garyStofer/AIR_TFT_12ADC/README.md

# AIR_TFT_12ADC
12x ADC for EGT and CHT on a TFT display using an ATMEGA 328P controller
