garyStofer/AIR_TFT_12ADC/hardware/12adc_Disp_AIR.sch

## EAGLE design hardware/12adc_Disp_AIR.sch (2020-06-30)

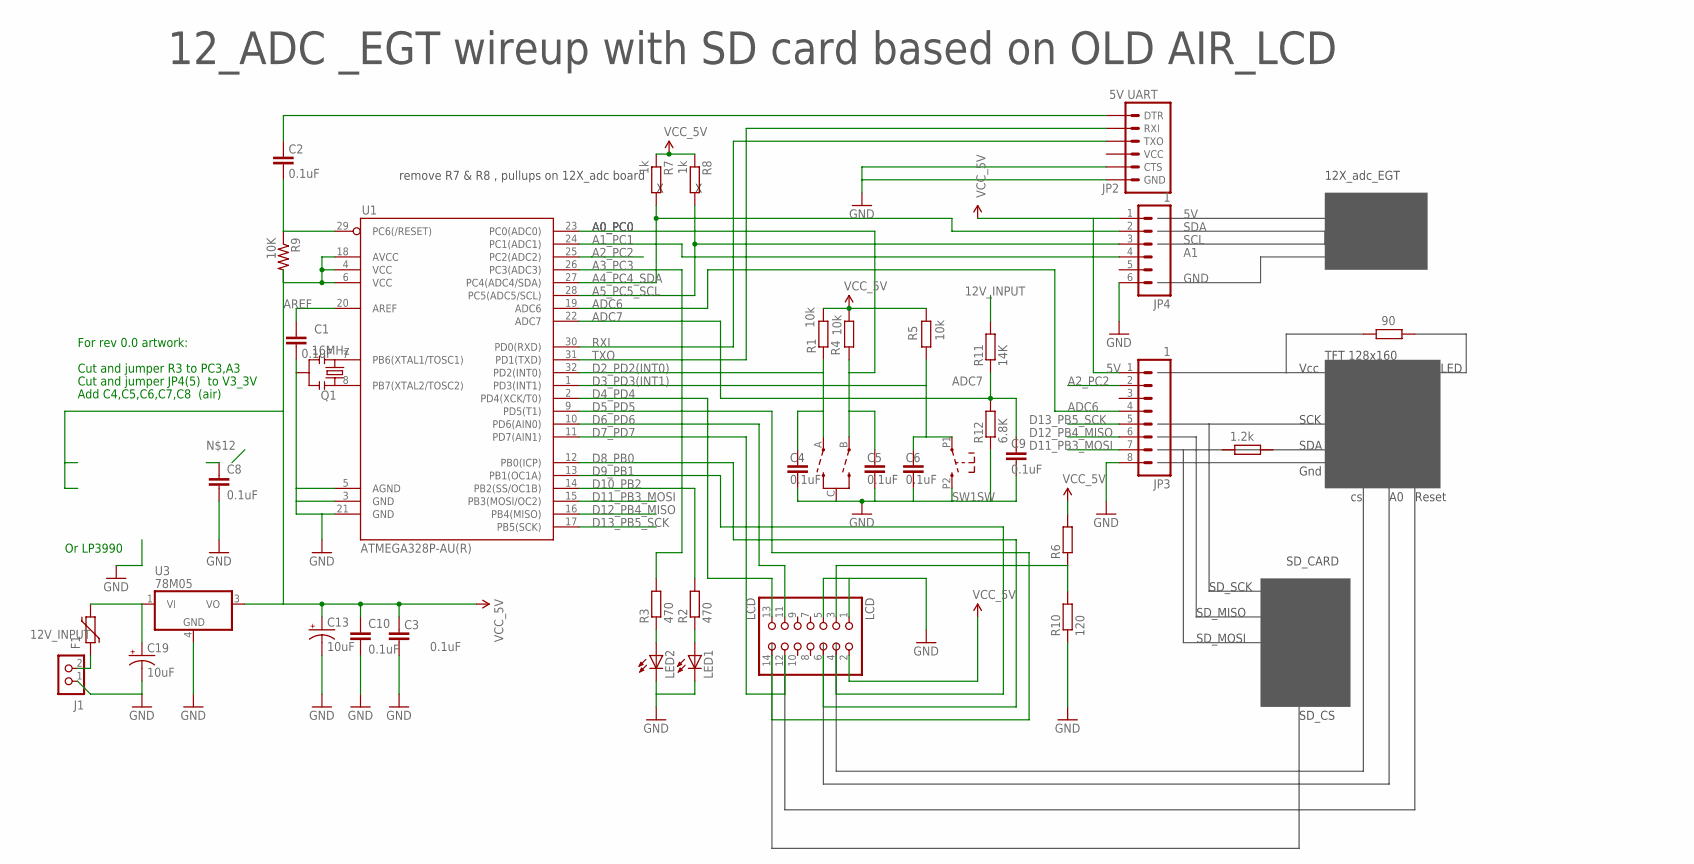
[picture p1: schematic 12adc_Disp_AIR.sch]

Parts:
C1, C2, C3, C4, C5, C6, C8, C9, C10: 0.1uF; 0805
C13: 10uF; EIA3216
C19: 10uF; EIA7343
F1: FUSE_PTC-0805; PTC0805
J1: 12V input; M1X2
JP2: 5V UART; 1X06
JP3: 1; 1X08
JP4: 1; 1X06
LCD: LCD; 2X07
LED1, LED2: LED-5MM
Q1: 16MHz; RESONATOR-SMD
R1, R4, R5: 10k; R603
R2, R3: 470; R603
R6: RESISTOR-0603; R603
R7, R8: 1k; R603
R9: 10K; 0603
R10: 120; R603
R11: 14K; R603
R12: 6.8K; R603
R13: 1.2k; R603
R14: 90; R603
SW1: ENCODER_SW1-PEC12; PEC12_INCREMENTAL_ENCODER
U1: ATMEGA328P-AU(R); TQFP32-08
U3: 78M05; DPACK

Connections:
5V: C3.2, C10.1, C13.A (+), JP3.1, JP4.1, LCD.2, R1.2, R4.1, R5.2, R6.2, R7.1, R8.1, R9.2, U1.4 (VCC), U1.6 (VCC), U1.18 (AVCC), U3.3 (VO)
12V_INPUT: C19.A (+), F1.2, R11.2, U3.1 (VI)
A0_PC0: C5.2, R4.2, SW1.B, U1.23 (PC0(ADC0))
A1_PC1: JP4.4, U1.24 (PC1(ADC1))
A2_PC2: JP3.2, U1.25 (PC2(ADC2))
A3_PC3: R3.2, U1.26 (PC3(ADC3))
A4_PC4_SDA: JP4.2, R7.2, U1.27 (PC4(ADC4/SDA))
A5_PC5_SCL: JP4.3, R8.2, U1.28 (PC5(ADC5/SCL))
ADC6: JP3.4, U1.19 (ADC6)
ADC7: C9.1, R11.1, R12.2, U1.22 (ADC7)
AREF: C1.2, U1.20 (AREF)
D2_PD2(INT0): C4.2, R1.1, SW1.A, U1.32 (PD2(INT0))
D3_PD3(INT1): C6.2, R5.1, SW1.P1 (1), U1.1 (PD3(INT1))
D4_PD4: LCD.13, U1.2 (PD4(XCK/T0))
D5_PD5: LCD.14, U1.9 (PD5(T1))
D6_PD6: LCD.11, U1.10 (PD6(AIN0))
D7_PD7: LCD.12, U1.11 (PD7(AIN1))
D8_PB0: LCD.6, U1.12 (PB0(ICP))
D9_PB1: LCD.4, U1.13 (PB1(OC1A))
D10_PB2: R2.2, U1.14 (PB2(SS/OC1B))
D11_PB3_MOSI: JP3.7, U1.15 (PB3(MOSI/OC2))
D12_PB4_MISO: JP3.6, U1.16 (PB4(MISO))
D13_PB5_SCK: JP3.5, U1.17 (PB5(SCK))
GND: C1.1, C3.1, C4.1, C5.1, C6.1, C8.2, C9.2, C10.2, C13.C (-), C19.C (-), J1.1, JP2.5 (CTS), JP2.6 (GND), JP3.8, JP4.6, LCD.1, LCD.5, LED1.K (C), LED2.K (C), Q1.2, R10.1, R12.1, SW1.C, SW1.P2 (2), U1.3 (GND), U1.5 (AGND), U1.21 (GND), U3.4 (GND)
unnamed: LCD.3, R6.1, R10.2
unnamed: Q1.1, U1.8 (PB7(XTAL2/TOSC2))
unnamed: C2.2, JP2.1 (DTR)
unnamed: Q1.3, U1.7 (PB6(XTAL1/TOSC1))
unnamed: F1.1, J1.2
unnamed: LED1.A, R2.1
unnamed: LED2.A, R3.1
RESET: C2.1, R9.1, U1.29 (PC6(/RESET))
RXI: JP2.3 (TXO), U1.30 (PD0(RXD))
TXO: JP2.2 (RXI), U1.31 (PD1(TXD))

Notes on the sheet:
SDA
SCL
GND
Cut and jumper R3 to PC3,A3
Cut and jumper JP4(5) to V3_3V
Add C4,C5,C6,C7,C8 (air)
For rev 0.0 artwork:
Or LP3990
SD_CARD
TFT 128x160
12X_adc_EGT
Reset
SCK
Vcc
Gnd
LED
SD_SCK
SD_MISO
SD_MOSI
SD_CS
12_ADC _EGT wireup with SD card based on OLD AIR_LCD
remove R7 & R8 , pullups on 12X_adc board
