garyStofer/AIR_TFT_12ADC/(commit log)

2018-10-30 added data sheets many changes in code -- Flying since 5-2018 in stinson
    [Arduino_jtagICE_config.txt]
2020-06-30 Added FAT16 SD card interface for storing temp readings on SD card file Changed font size for initial voltage read out. changed Alarm settings (red LED) added a Eagle schematic including wiring with 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
    [12adc_Disp_AIR.sch]
2022-02-23 added CHT mode with Ktype probes
2023-06-22 reworked entire script to read from two ADC's and display toggle between CHT and EGT
    [AIR_TFT_12ADC.ino]
2023-07-27 Added code to handle rotary Encoder Added display of up-time and battery voltage by turning knob Change CHT zoom range to start at 200F Added include file BoardPins.h to keep pin connection defines i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
2025-09-16 removed J type couple coefficients
2025-09-16 Added/changed code to require multiple consecutive encoder clicks to register for one encoder count increment. this is to help with bouncy encoder knobs and with encoder detents that don't match up w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
2025-09-16 added defines for different models display boards and for SD-Card code exclusion
2025-09-16 Added simulation mode to run without ADC boards for testing. added 2 Aux channels to be displayed on the status page added the cold junction temp to be displayed on the status page Changed the displa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
    [AIR_TFT_12ADC.ino]
2026-06-05 Added simulation mode to test without ADC's Added labels for the aux channels to identify what is being measured.
